Murinho/F1-in-Schools/Pit_Display_Portfolio.pdf

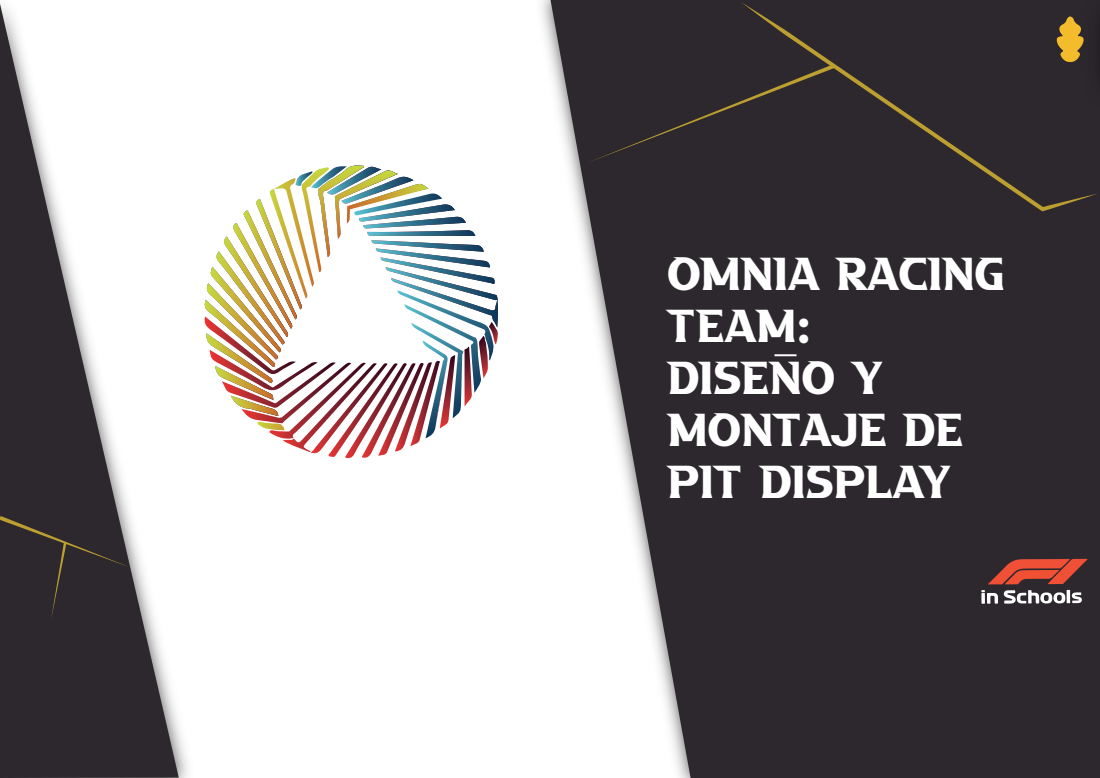
[picture p24: page 1]
Omnia Racing Team: diseno y montaje de pit display

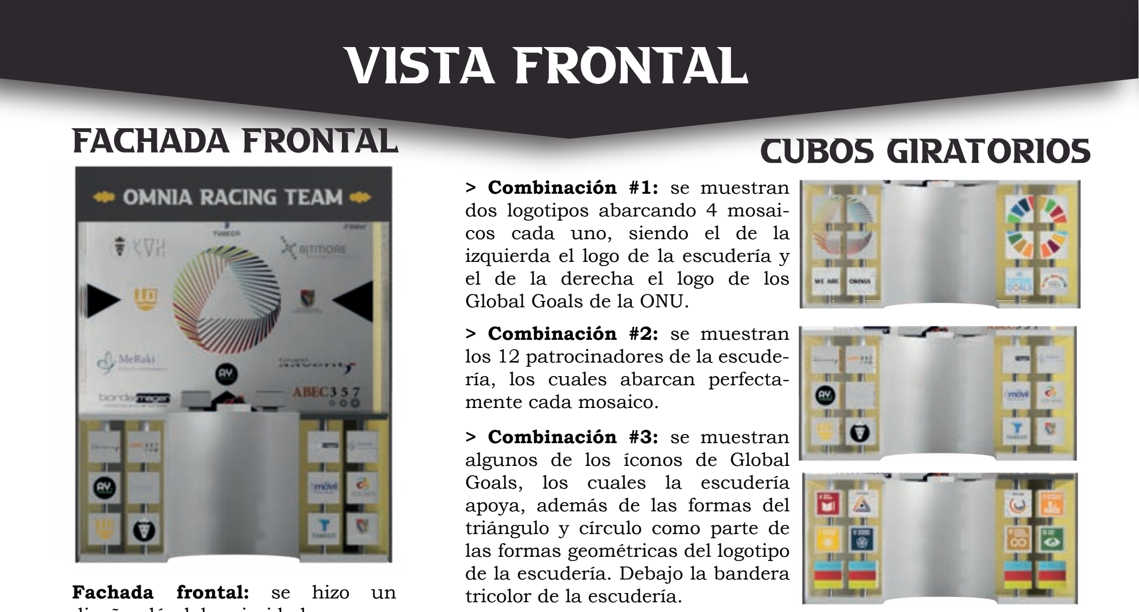
[picture p25: figure]
Vista frontal; Fachada Frontal; Fachada frontal: se hizo un; Cubos giratorios > Combinación #1: se muestran dos logotipos abarcando 4 mosai- cos cada uno, siendo el de la izquierda el logo de la escudería y el de la derecha el logo de los Global Goals de la ONU. > Combinación #2: se muestran los 12 patrocinadores de la escude- ría, los cuales abarcan perfecta- mente cada mosaico. > Combinación #3: se muestran algunos de los íconos de Global Goals, los cuales la escudería apoya, además de las formas del triángulo y círculo como parte de las formas geométricas del logotipo de la escudería. Debajo la bandera tricolor de la escudería.

diseño, dándole prioridad a que sea estéticamente apelativo al público a primera vista, con información relevante, llamativa pero a la vez evitando saturar de detalles para que sea agradable de observar.

> Combinación #4: se muestran algunos breves textos sobre el significado de los íconos de la combinación #3, además de los logos de F1 in Schools y de las redes sociales que tiene la escudería.

# Dentro del Pit display

## auto y material

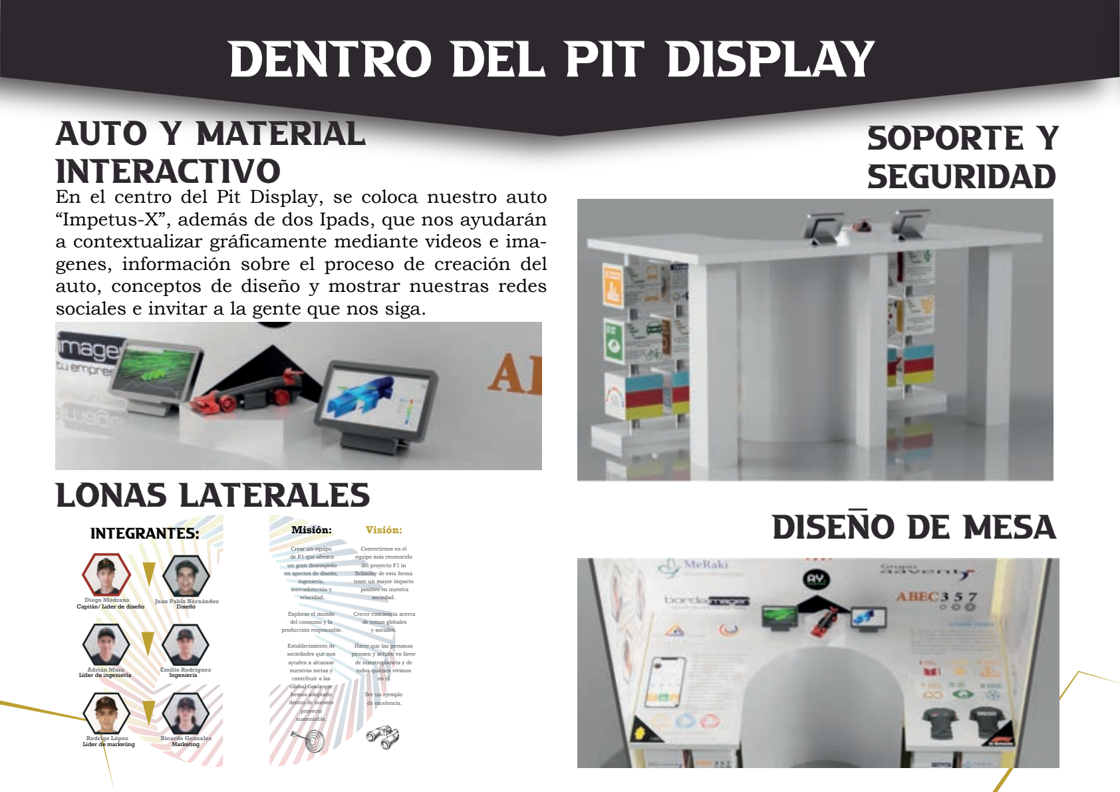
[picture p26: page 3]
Lonas laterales; Diego Medrano; Capitán/ Lider de diseño; Diseño Juan Pablo Hernández; Marketing Rodrigo López; Ricardo Gonzalez; iNTEGRANTES:; Convertirnos en el; Misión:; Visión:; diseno de mesa; SOPORTE Y SEGURIDAD

interactivo
En el centro del Pit Display, se coloca nuestro auto
“Impetus-X”, además de dos Ipads, que nos ayudarán
a contextualizar gráficamente mediante videos e ima-
genes, información sobre el proceso de creación del
auto, conceptos de diseño y mostrar nuestras redes
sociales e invitar a la gente que nos siga.

Crear un equipo
de F1 que ofrezca
un gran desempeño
en apectos de diseño,
ingeniería,
mercadotecnia y
velocidad.

equipo más reconocido
del proyecto F1 in
Schoolsy de esta forma
tener un mayor impacto
positivo en nuestra
sociedad.

Explorar el mundo
del consumo y la
producción responsable.

Crecer conciencia acerca
de temas globales
y sociales.

Establecimiento de
sociedades que nos
ayuden a alcanzar
nuestras metas y
contribuir a las
Global Goals que
hemos adoptado
dentro de nuestro
proyecto
sustentable.

Hacer que las personas
piensen y actúen en favor
de nuestroplaneta y de
todos quienes vivimos

Emilio Rodriguez Ingeniería Adrián Muro Líder de ingeniería

Ser un ejemplo
de excelencia.

Lider de marketing

# renders Adicionales

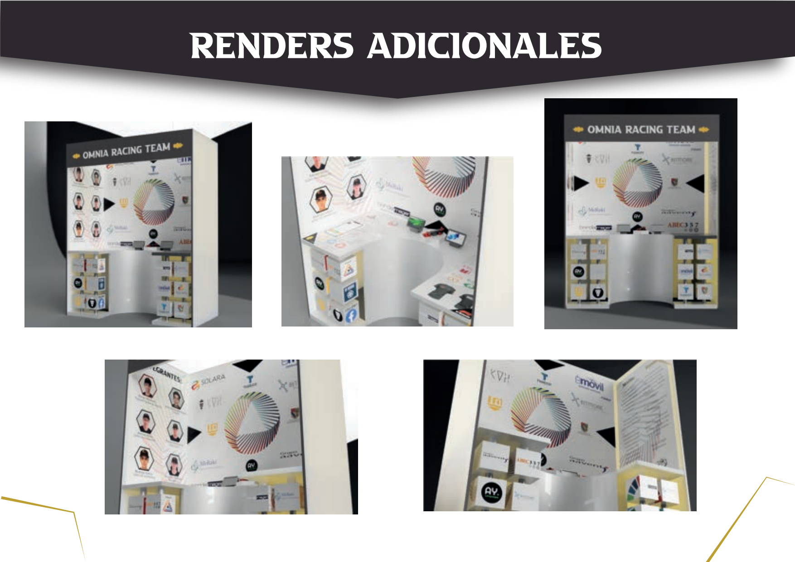
[picture p27: page 4]
