Murinho/F1-in-Schools/Racing Car Ready .iges

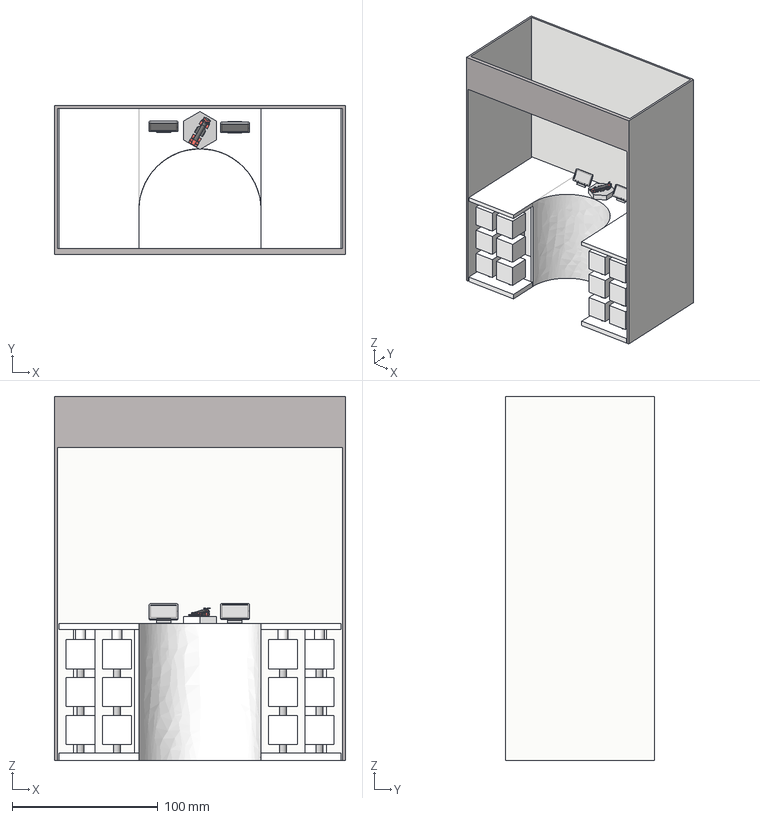
[picture p28: CAD file, 2021-10-23]
Racing Car Ready .iges
200.0 x 102.0 x 250.0 mm
